xrayer2000/PID-demo/PicturesAndMovies/BLDC_cycloidal actuatorV1.jpg

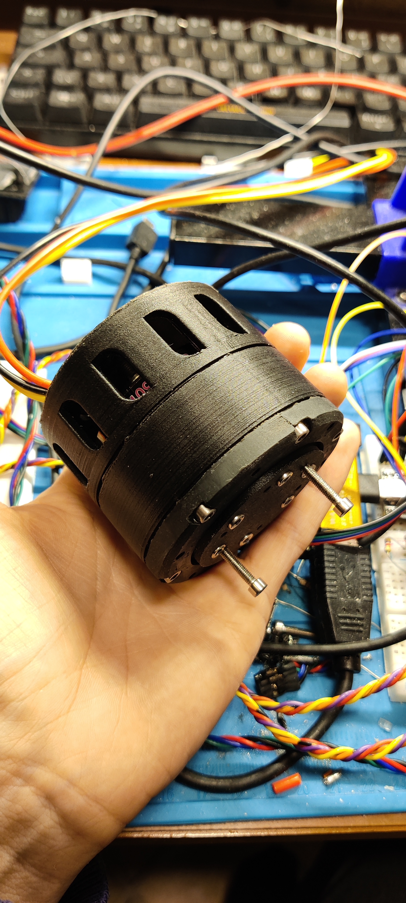
PicturesAndMovies/BLDC_cycloidal actuatorV1.jpg
