xrayer2000/PID-demo/PicturesAndMovies/cycloidal actuatorV1.jpg

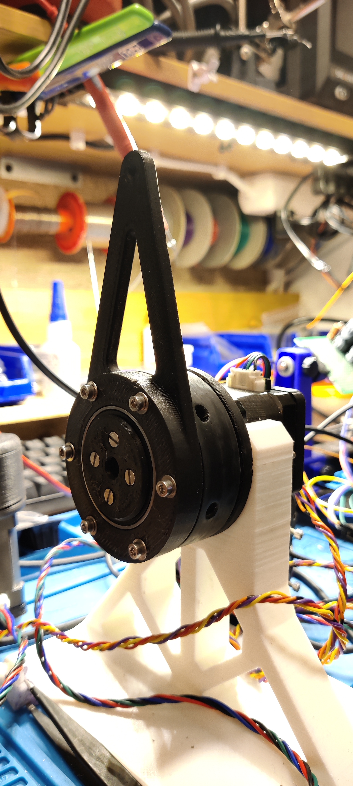
PicturesAndMovies/cycloidal actuatorV1.jpg
