xrayer2000/PID-demo/PicturesAndMovies/cycloidal actuatorV2.jpg

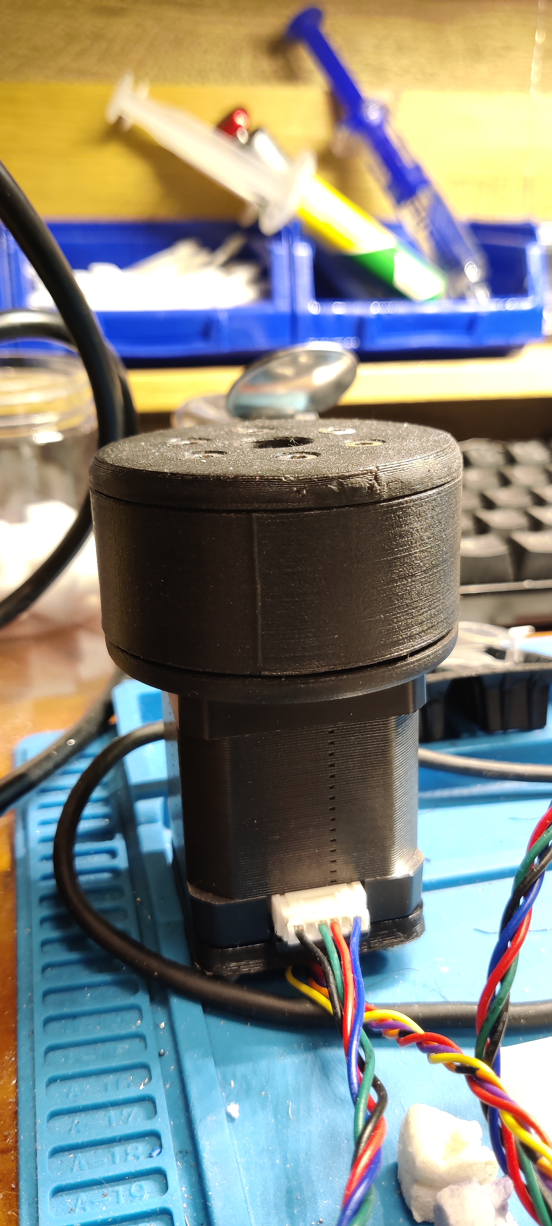
PicturesAndMovies/cycloidal actuatorV2.jpg
