xrayer2000/PID-demo/PicturesAndMovies/PCB for the TMC2209.jpg

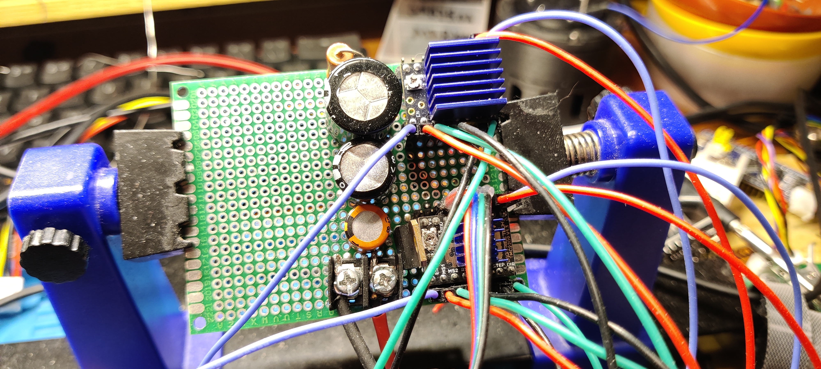
PicturesAndMovies/PCB for the TMC2209.jpg
