xrayer2000/PID-demo/PicturesAndMovies/STM32F411 prototyping board.jpg

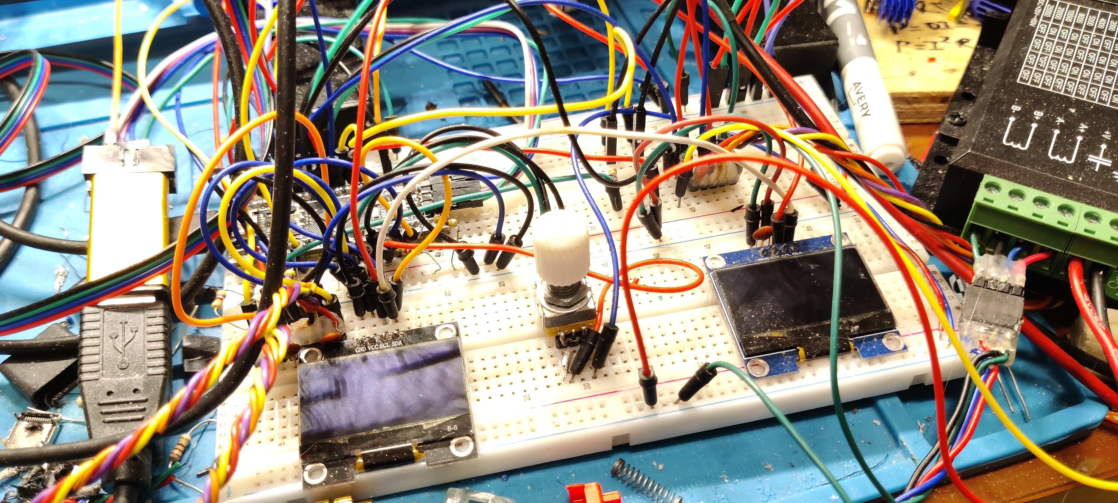
PicturesAndMovies/STM32F411 prototyping board.jpg
