xrayer2000/PID-demo/PicturesAndMovies/Stepper_DevPlatform_CuriousScientist_PCBWay Community.xls

 |  |  | Stepper motor developing platform BOM – Curious Scientist
Item # | *Designator | *Qty | Manufacturer | *Mfg Part # | Description / Value | *Package/Footprint | Type | Your Instructions / Notes
1 | C2, C6 | 2 | Kyocera AVX | 0603YC104J4T4A | 16V, 100 nF ceramic capacitor | 0603 | SMD
2 | C3, C4 | 2 | TDK | C1608X5R0J226M080AC | 6.3V, 22 uF ceramic capacitor | 0603 | SMD
3 | C1 | 1 | TDK | C3225X7R2A106K250AC | 100V, 10 uF ceramic capacitor | 1210 | SMD
4 | C7 | 1 | KEMET | ESY107M035AG3AA | 35V, 100 uF electrolytic capacitor | d=8mm, p=3.5 mm | Thru-hole
5 | R4, R5, R6, R7 | 4 | Kamaya | RMC16K472FTP | 4k7 thin film resistor 1% | 0603 | SMD
6 | R1, R2 | 2 | Kamaya | RMC16K104FTP | 100k thin film resistor 1% | 0603 | SMD
7 | R3, R8 | 2 | Susumu | RG1608N-102-B-T5 | 1k thin film resistor 1% | 0603 | SMD
8 | L1 | 1 | Bourns | SRP7028A-4R7M | 4.7 mH inductance 20% | 7028 | SMD
9 | D1 | 1 | Kingbright | APT1608SURCK | Red LED | 0603 | SMD | Use any color you like.
10 | U1 | 1 |  |  | STM32F401CCU6 microcontroller board | - | Thru-hole | https://s.click.aliexpress.com/e/_A2A5iO , You can optionally add 2x20 pin female headers to make the microcontroller exchangeable
11 | U2 | 1 | Diodes Inc | AP63203WU-7 | 3.3 V, 2 A Buck controller chip | TSOT-26-6 | SMD
12 | U3 | 1 | ams OSRAM | AS5600-ASOM | AS5600 12-bit magnetic encoder | SOIC-8 | SMD | Don't forget the diametrically magnetized magnet! D = 5 mm and h = 2.5 mm is perfect for NEMA17 shafts. https://s.click.aliexpress.com/e/_AEJrJf
13 | U4 | 1 |  |  | TMC2209 module | - | Thru-hole | https://s.click.aliexpress.com/e/_DmiXsST , You can optionally add 2x8 pin female headers to make the motor driver exchangeable. It is important to buy the same type as I used because some modules have different pin layout.
14 | SW1, SW2 | 1 | Apem | MJTP1212A | 12 mm Tactile SPST switch | - | Thru-hole | You can add caps, if you want.
15 | J1 | 1 |  |  | Rotary encoder module | - | Thru-hole | https://s.click.aliexpress.com/e/_9Ak6WS, You can alternatively build my project: https://www.pcbway.com/project/shareproject/Debounced_rotary_encoder_module_8985334a.html
16 | J2 | 1 | Amphenol FCI | 67997-100HLF | 2 pin, 2.54 mm pin header | - | Thru-hole | Must be accompanied with PRT-09044 (2-pin jumper)
17 | J3, J4 | 1 | Amphenol FCI | 77311-118-03LF | 3 pin, 2.54 mm header | - | Thru-hole
19 | J5 | 1 | CUI Devices | TBP01R1-508-04BE | 4-hole terminal block, 5.08 mm pitch | - | Thru-hole | Must be accompanied with TBP01P1-508-04BE (terminal block plug). Alternatively, can be omitted and the stepper motor wires can be soldered directly in the board.
21 | J7 | 1 | Wurth Elektronik | 694106301002 | DC barrel connector 5.5x2.1mm | DC Power Jack | Thru-hole | Pin 1 = VCC, Pin 2, 3 = GND
22 | J8 | 1 |  |  | 128x64 Graphical LCD with SPI |  |  | https://s.click.aliexpress.com/e/_Aq1gUO. You can add a 77311-818-13LF 1x13P header to attach the LCD to the board.
Need a quick and accurante quote? Need an efficient production? Please read SMT Ordering Necessary Files & Info in 1 minute. Thank you very much! (https://www.pcbway.com/smt_ordering_guide.html)
Click for Instructions on How to Create a BOM (https://www.pcbway.com/blog/PCB_Assembly/How_to_Build_a_BOM__Bill_Of_Materials_.html)
