xrayer2000/PID-demo/InventorCad/AS5600Mount_nema17.stl

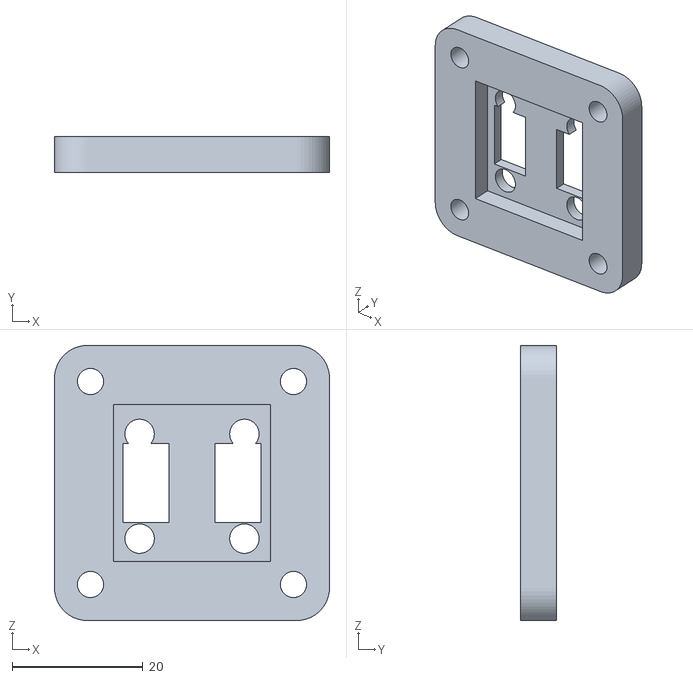
[picture p9: CAD file, 2026-08-18]
InventorCad/AS5600Mount_nema17.stl
42.0 x 5.50 x 42.0
