xrayer2000/PID-demo/Kicad/PID_DEMO/PID_DEMO.kicad_pcb

## KiCad design Kicad/PID_DEMO/PID_DEMO.kicad_pcb (2026-08-18)

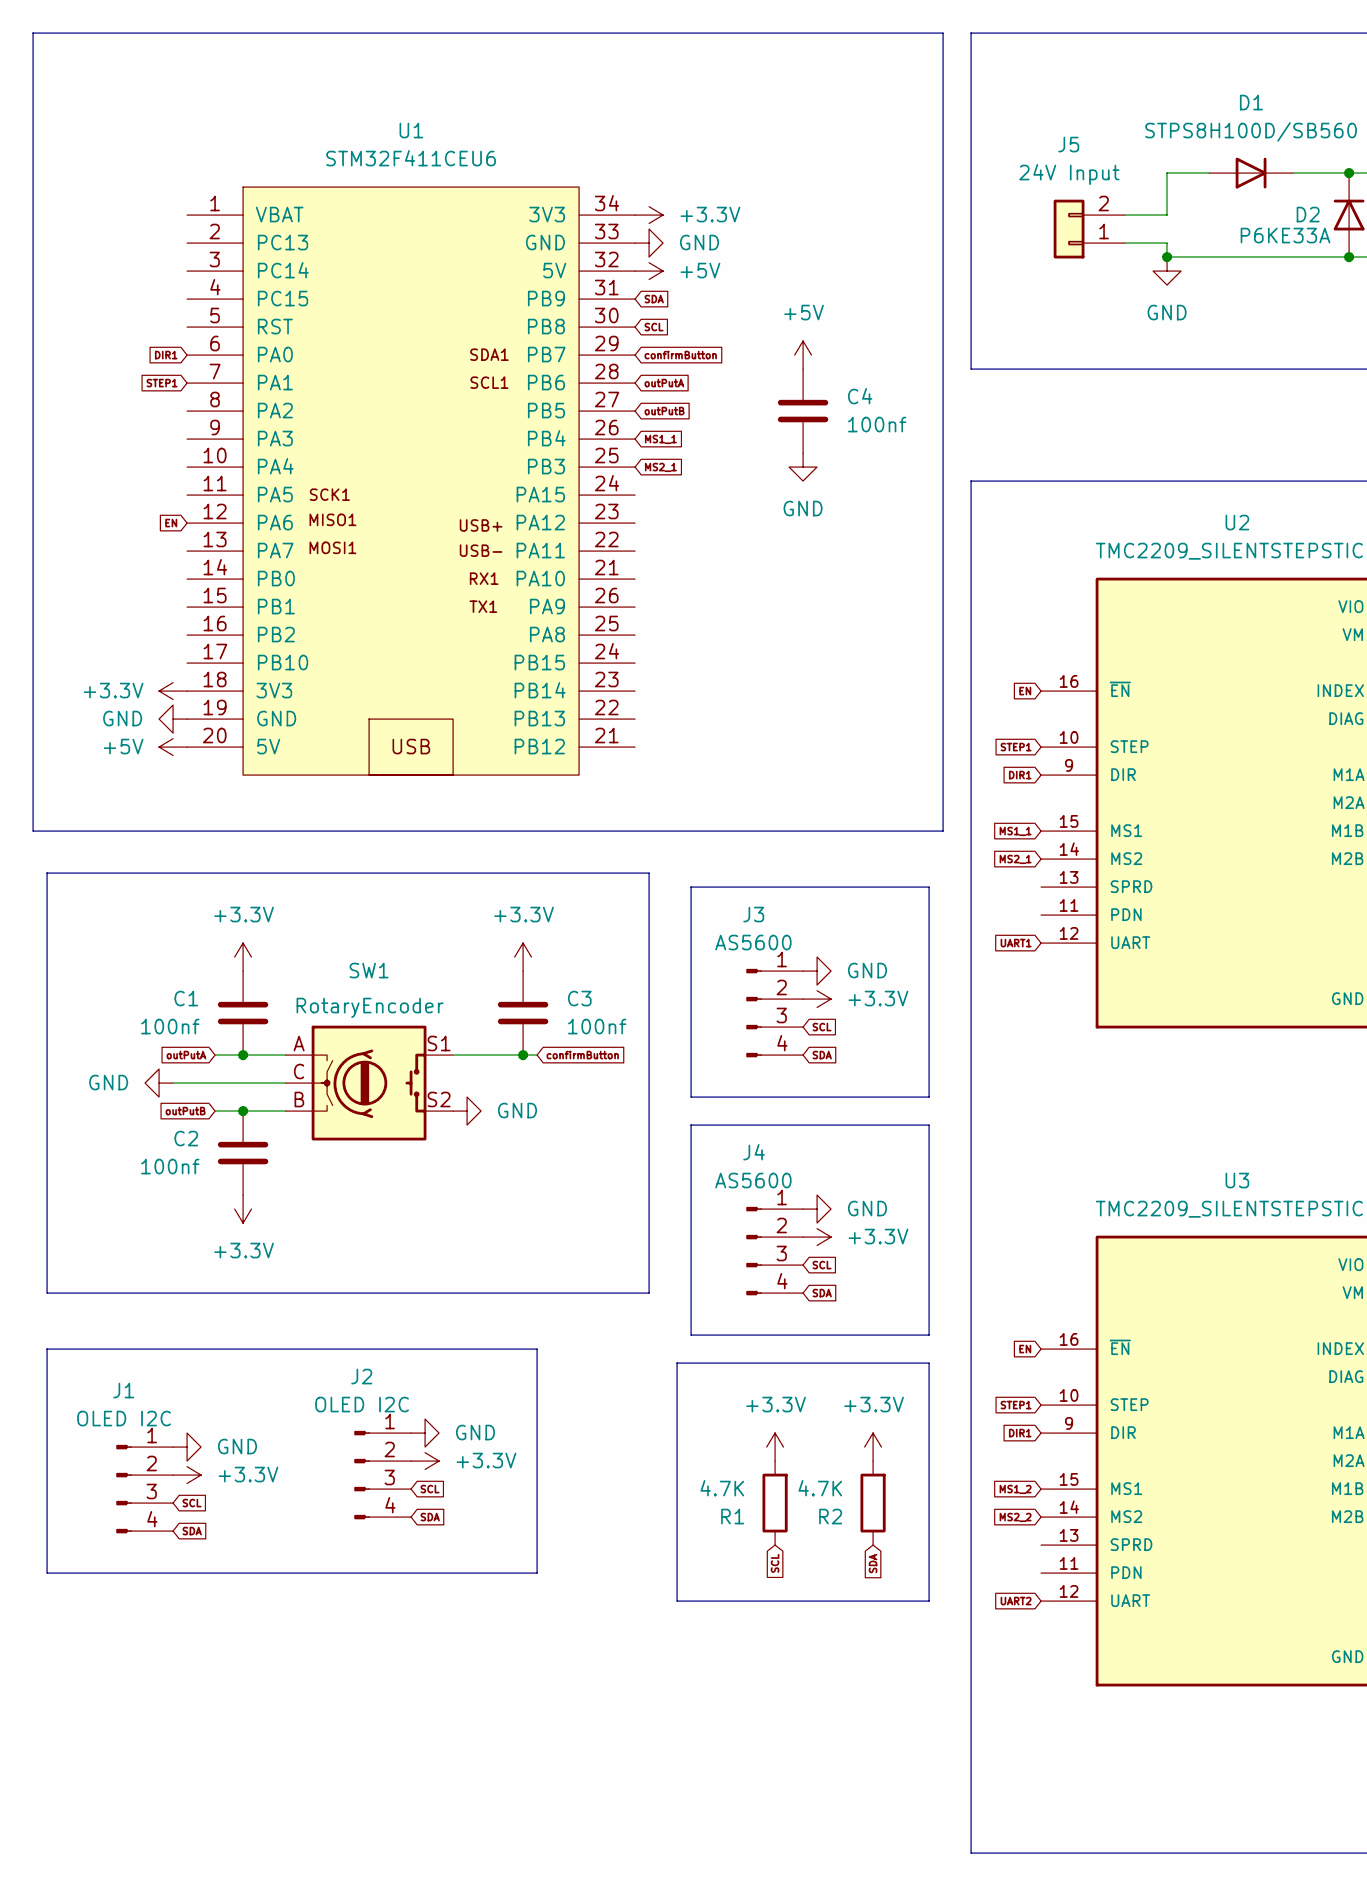
[picture p10: schematic PID_DEMO.kicad_sch, part in row 1, column 1]

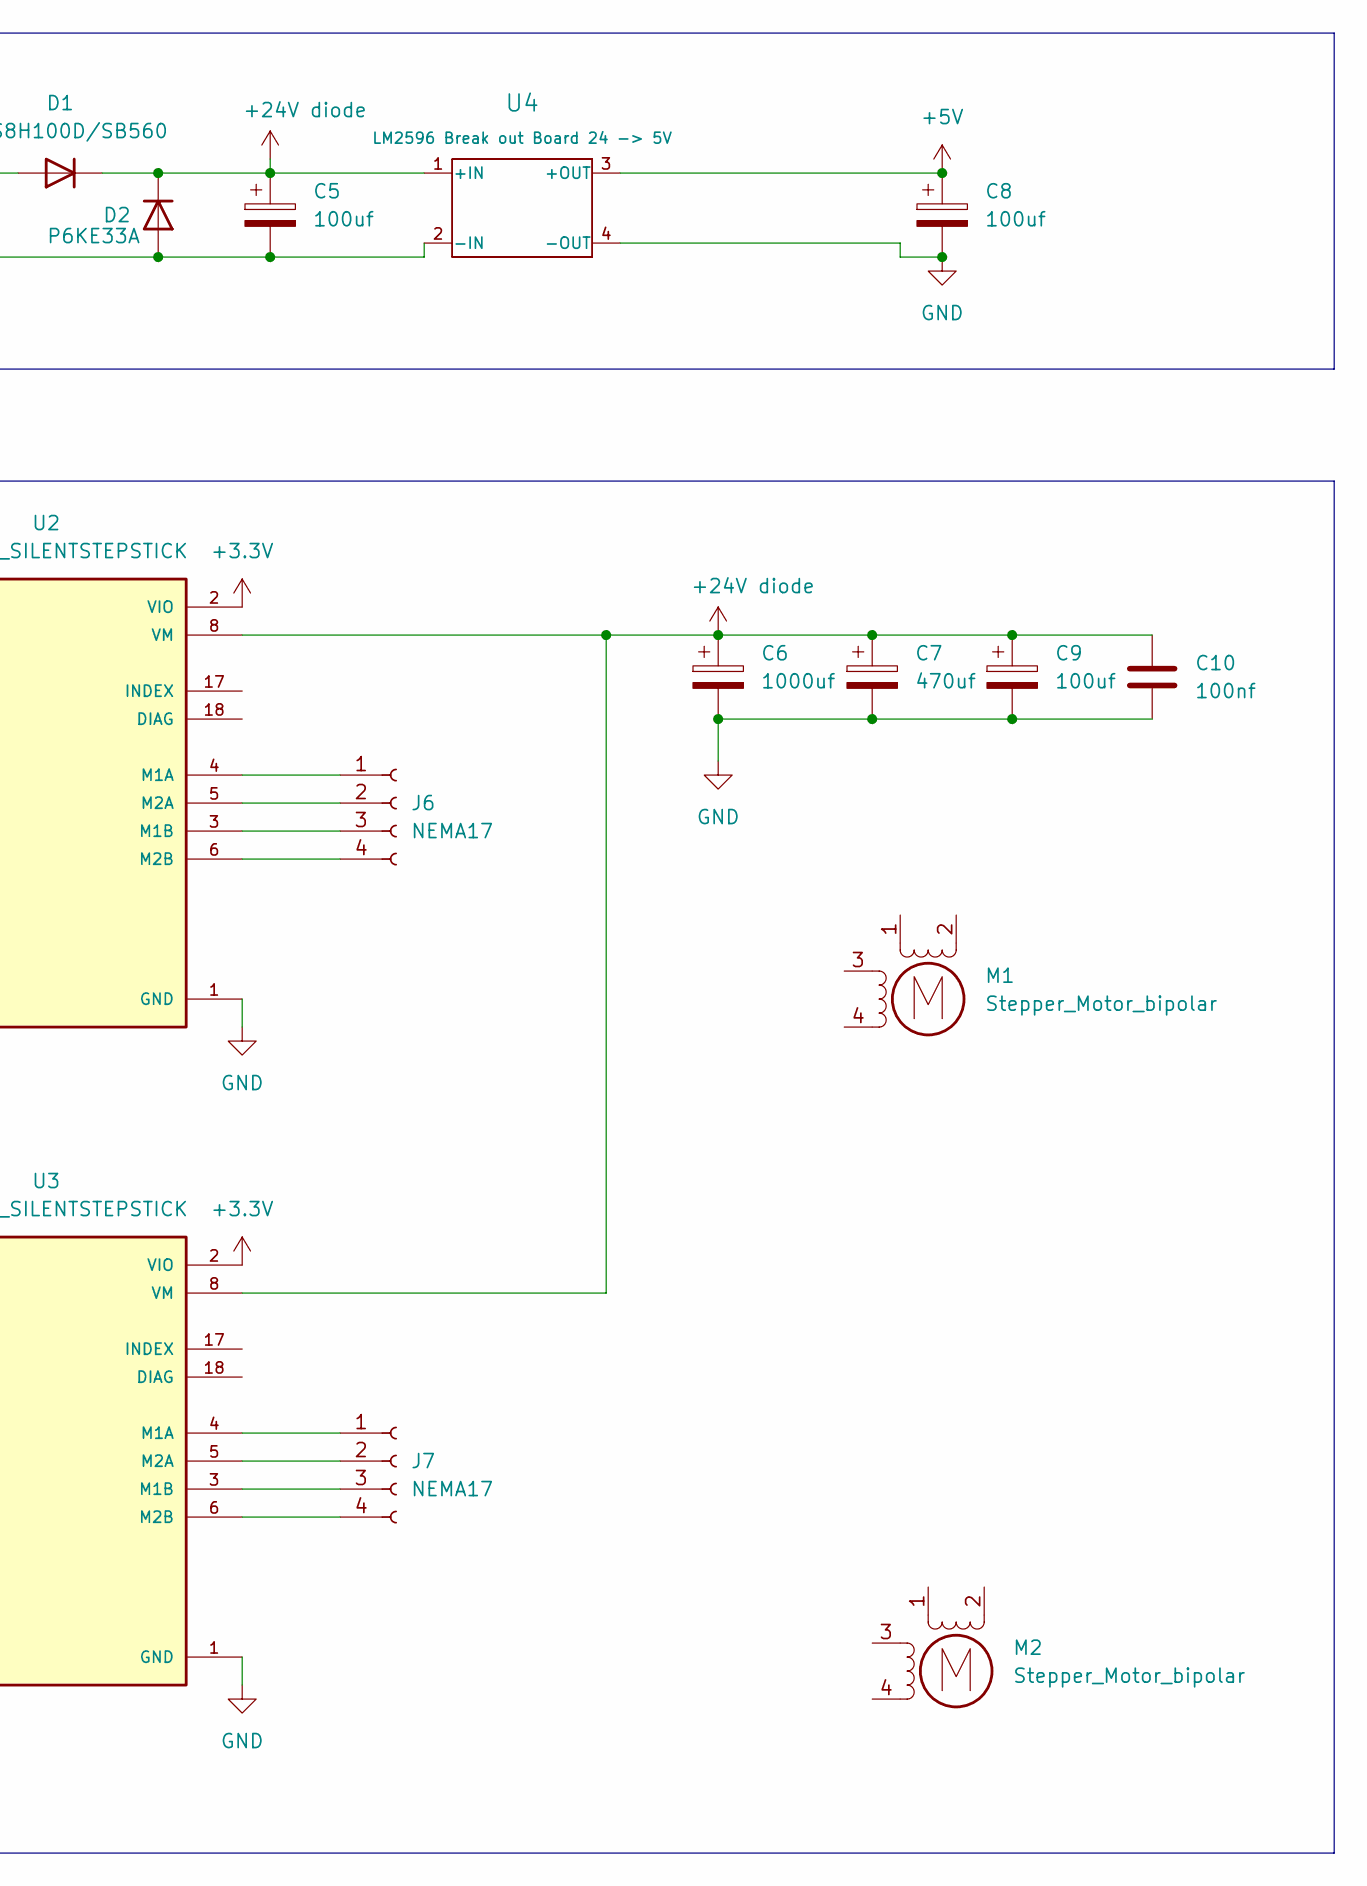
[picture p11: schematic PID_DEMO.kicad_sch, part in row 1, column 2]

Parts:
C1, C2, C3, C4, C10: 100nf; C_Disc_D3.0mm_W1.6mm_P2.50mm
C5, C8: 100uf; CP_Radial_D5.0mm_P2.00mm
C6: 1000uf; CP_Radial_D16.0mm_P7.50mm
C7: 470uf; CP_Radial_D13.0mm_P5.00mm
C9: 100uf; CP_Radial_D10.0mm_P5.00mm
D1: STPS8H100D/SB560; D_DO-15_P5.08mm_Vertical_AnodeUp
D2: P6KE33A; D_DO-15_P5.08mm_Vertical_AnodeUp
J1, J2: OLED I2C; ssd1306_1.3''
J3, J4: AS5600; JST_XH_B4B-XH-A_1x04_P2.50mm_Vertical
J5: 24V Input; TerminalBlock_Phoenix_MKDS-1,5-2_1x02_P5.00mm_Horizontal
J6, J7: NEMA17; JST_XH_B4B-XH-A_1x04_P2.50mm_Vertical
M1, M2: Stepper_Motor_bipolar; NEMA17
R1, R2: 4.7K; R_Axial_DIN0207_L6.3mm_D2.5mm_P7.62mm_Horizontal
SW1: RotaryEncoder; RotaryEncoder_Alps_EC11E-Switch_Vertical_H20mm
U1: STM32F411CEU6; YAAJ_BlackPill_1
U2, U3: TMC2209_SILENTSTEPSTICK; MODULE_TMC2209_SILENTSTEPSTICK; PARTREV 1.20
U4: LM2596 Break out Board 24 -> 5V; DC_DC_LM2596_small

Connections:
+3.3V: C1.1, C2.2, C3.1, J1.2, J2.2, J3.2, J4.2, R1.2, R2.2, U1.18 (3V3), U1.34 (3V3), U2.2 (VIO), U3.2 (VIO)
+5V: C4.1, C8.1, U1.20 (5V), U1.32 (5V), U4.3 (+OUT)
+24V diode: C5.1, C6.1, C7.1, C9.1, C10.1, D1.1 (K), D2.1 (K), U2.8 (VM), U3.8 (VM), U4.1 (+IN)
DIR1: U1.6 (PA0), U2.9 (DIR), U3.9 (DIR)
EN: U1.12 (PA6), U2.16 (~EN), U3.16 (~EN)
GND: C4.2, C5.2, C6.2, C7.2, C8.2, C9.2, C10.2, D2.2 (A), J1.1, J2.1, J3.1, J4.1, J5.1, SW1.C, SW1.S2, U1.19 (GND), U1.33 (GND), U2.1 (GND), U2.7 (GND), U3.1 (GND), U3.7 (GND), U4.2 (-IN), U4.4 (-OUT)
MS1_1: U1.26 (PB4), U2.15 (MS1)
MS1_2: U3.15 (MS1)
MS2_1: U1.25 (PB3), U2.14 (MS2)
MS2_2: U3.14 (MS2)
unnamed: D1.2 (A), J5.2
unnamed: J6.1, U2.4 (M1A)
unnamed: J6.2, U2.5 (M2A)
unnamed: J6.3, U2.3 (M1B)
unnamed: J6.4, U2.6 (M2B)
unnamed: J7.1, U3.4 (M1A)
unnamed: J7.2, U3.5 (M2A)
unnamed: J7.3, U3.3 (M1B)
unnamed: J7.4, U3.6 (M2B)
SCL: J1.3, J2.3, J3.3, J4.3, R1.1, U1.30 (PB8)
SDA: J1.4, J2.4, J3.4, J4.4, R2.1, U1.31 (PB9)
STEP1: U1.7 (PA1), U2.10 (STEP), U3.10 (STEP)
UART1: U2.12 (UART)
UART2: U3.12 (UART)
confirmButton: C3.2, SW1.S1, U1.29 (PB7)
outPutA: C1.2, SW1.A, U1.28 (PB6)
outPutB: C2.1, SW1.B, U1.27 (PB5)

Board: 2 copper layers, 28 parts (5 on the bottom side), 23 nets, no tracks yet.
