xrayer2000/PID-demo/ArduinoCode/src/config.h

#pragma once

//--------------------------------------------------------------------------------------------------
// Task periods (ms)
//--------------------------------------------------------------------------------------------------
constexpr uint32_t TASK_1HZ   = 1000;
constexpr uint32_t TASK_5HZ   = 500;
constexpr uint32_t TASK_10HZ   = 100;
constexpr uint32_t TASK_20HZ   = 50;
constexpr uint32_t TASK_50HZ   = 20;
constexpr uint32_t TASK_100HZ  = 10;
constexpr uint32_t TASK_200HZ  = 5;
constexpr uint32_t TASK_500HZ  = 2;
constexpr uint32_t TASK_1000HZ = 1;
//--------------------------------------------------------------------------------------------------
// Hardware timer frequencies [Hz]
//--------------------------------------------------------------------------------------------------
constexpr uint32_t TIMER_10KHZ   = 10000;
constexpr uint32_t TIMER_20KHZ   = 20000;
constexpr uint32_t TIMER_50KHZ   = 50000;
constexpr uint32_t TIMER_100KHZ  = 100000;
