xrayer2000/PID-demo/(commit log)

2024-11-29 updated PID demo 2024-11-29
2024-11-30 modified PID-demo_Angle 2024-11-30
2026-03-22 added main.inom new start for Stepper motors
2026-08-18 changed as5600 library, renamed U8g2_Arduino-master, etc
    [AS5600Mount_nema17.stl, PID_DEMO.kicad_pcb, PID_DEMO.kicad_sch, Stepper_DevPlatform_CuriousScientist_PCBWay Community.xls]
2026-11-05 Update README with mechanical assembly and project features
    Added mechanical assembly details and updated project features.
